ganiushin/MaGaRM/docs/cad.md

# CAD: сборка из скриптов и правки

## Как устроено

`cad/base/base_assembly.step` — исходная сборка. Скрипты меняют её по шагам:

| Скрипт | Что делает |
|---|---|
| `step1_J1.py` | J1 на DM-JH17-101: новое основание с кольцом под мотор и окнами под разъёмы |
| `step2_J2.py` | J2 на DM-JH17-101: мотор в барабане на конце плеча, вилка L2_base со щекой L2_cheek и подшипником 6705. J3 на DM-J4340P: плечо и вилка предплечья расширены симметрично, зазоры 1.75 мм |
| `step3_J4.py` | J4 на DM-J4340: корпус-барабан Ø63, ступица L4_right, вырез поперечины, выборка под ход мотора J6 (J5 ±90°) |
| `step4_gripper.py` | захват на DM-H3510: стакан L7_motor, рама на фланце Ø60, кривошип |
| `step5_logo.py` | логотип MaGaRM гравировкой 0.8 мм на плече (L3_back) |
| `make_viewer.py` | `viewer/model.json` для просмотрщика |
| `export_parts.py` | все печатные детали в `cad/parts/` (STEP + герметичные STL) и `parts.json` |
| `make_urdf.py` | `urdf/magarm.urdf` и сетки звеньев |

Полная пересборка занимает около 15 минут. Нужен [uv](https://docs.astral.sh/uv/), он сам поставит build123d:

```bash
cad/scripts/build_all.sh
```

Промежуточные сборки весят по 100–200 МБ, они складываются в `cad/build/` и в git не попадают.

## Правка

**В CAD.** Откройте деталь из `cad/parts/*.step` в Fusion 360, Onshape или FreeCAD и правьте прямым моделированием (Press Pull, Move face, Delete face). Чтобы видеть соседние детали, откройте полную сборку `cad/build/step5/magarm_step5_logo.step`.

**Параметрами.** Поменяйте число в начале скрипта и запустите `build_all.sh`:

| Файл | Параметр | Смысл |
|---|---|---|
| step1_J1.py | `R_OUT`, `R_IN`, `RING` | башня основания, расточка под корпус мотора, толщина кольца |
| step1_J1.py | `WIN_Y`, `WIN_Z` | окна под разъёмы J1 |
| step2_J2.py | `R_BORE`, `R_DRUM`, `WALL_F`, `WALL_B` | барабан плеча под мотор J2: расточка, наружный радиус, стенка под винты статора, задняя стенка |
| step2_J2.py | `W_FL`, `Z_FL`, `CH_T`, `R_CH` | вилка: полуширина и верх пола, толщина и радиус щеки с подшипником |
| step2_J2.py | `R_SPIGOT` | цапфа под подшипник 6705 на L3_back |
| step2_J2.py | `D_FORK`, `D_ARM` | раздвижка вилки J3 и половин плеча |
| step3_J4.py | `RI`, `RO` | внутренний и наружный радиус барабана J4 |
| step3_J4.py | `R_HUB` | ступица под выход мотора в L4_right |
| step3_J4.py | `PART_ANG`, `ROT_M` | угол разъёма L5_motor/L5_back, поворот мотора J4 |
| step4_gripper.py | `BOT`, `R_FL`, `R_FS`, `ROLL` | дно стакана, фланец, радиус винтов рамы, поворот мотора захвата (разъёмы) |

Ось J1 стоит под осью J2, в средней плоскости плеча. Высота выхода J1 (`Z_OUT` в step1_J1.py) и пол вилки (`Z_FL` в step2_J2.py) связаны: пол проходит в 1.6 мм под барабаном плеча. Меняются вместе, step2_J2.py это проверяет.

После каждого изменения скрипты проверяют, что тела валидны и объём изменился ровно на ожидаемую величину. Если булева операция не удалась, сборка падает с ошибкой, а не выдаёт битую деталь.
