ganiushin/MaGaRM/docs/electrical.md

# Электрика

## Питание

Все моторы питаются от одной шины 24 В:
- Damiao JH17 — 24–48 В, здесь работает на 24 В;
- Damiao 4340P и 4340 — номинал 24 В;
- H3510 — 24–30 В;
- EL05 работает от 15–60 В (номинал 48 В). На 24 В у него меньше максимальная скорость, около 200 об/мин, для запястья этого хватает.

Блок питания:
- **24 В, от 15 А.** В покое рука потребляет 1–2 А. Каждый JH17 на пиковом моменте берёт от шины до 7 А, номинально 1.6 А (паспорт, 24 В);
- **предохранитель 20 А** сразу после блока питания;
- **кнопка аварийного отключения**, которая разрывает +24 В. Это механическая кнопка, а не программная остановка: при пропадании питания моторы отпускают, и рука под своим весом падает, так что держите её в рабочей зоне без людей;
- **провод питания** от блока до основания — сечением от 1 мм² (18 AWG).

## CAN

Все 7 моторов сидят на одной шине CAN 2.0, 1 Мбит/с:
- Damiao используют стандартные 11-битные кадры;
- RobStride EL05 — расширенные 29-битные.

На одной шине они не мешают друг другу. Адреса:

| Сустав | Мотор | Протокол | ID |
|---|---|---|---|
| J1 | DM-JH17-101 | Damiao MIT | 0x01 (ответ 0x11) |
| J2 | DM-JH17-101 | Damiao MIT | 0x02 (ответ 0x12) |
| J3 | DM-J4340P | Damiao MIT | 0x03 (ответ 0x13) |
| J4 | DM-J4340 | Damiao MIT | 0x04 (ответ 0x14) |
| J5 | EL05 | RobStride | 5 |
| J6 | EL05 | RobStride | 6 |
| Захват | DM-H3510 | Damiao MIT | 0x07 (ответ 0x17) |

Топология:
- **шина — одна линия** без длинных ответвлений: основание → J1 → J2 → J3 → J4 → J5 → J6 → захват;
- **терминаторы 120 Ом на обоих концах:** один на адаптере USB–CAN (у CANable включается перемычкой), второй на захвате. Если в плате-переходнике H3510 терминатора нет, поставьте резистор 120 Ом между CAN_H и CAN_L в последнем разъёме;
- **проверка:** между CAN_H и CAN_L на выключенной шине должно быть около 60 Ом.

## Жгут

Моторы соединяются цепочкой кабелями XT30(2+2): два толстых провода питания и пара CAN в одном разъёме. У каждого мотора два таких разъёма, вход и выход.

| Участок | Где проходит кабель |
|---|---|
| Основание → J1 | через окно L1_base: два разъёма JH17 смотрят в два окна, спереди и сзади |
| J1 → J2 | снаружи, петлёй от второго окна основания к окну в L3_back у корня плеча: там единственный доступный разъём мотора J2 |
| J2 → J3 | ответвление от того же кабеля в окне L3_back, дальше по центральному каналу плеча (6×8 мм между половинами) |
| J3 → J4 | вдоль предплечья, в канал половин L4 |
| J4 → J5 | через цапфу барабана (отверстие Ø12) в плиту J5 |
| J5 → J6 → захват | по L6_link, затем вниз к окну стакана L7_motor |

H3510 подключается через плату-переходник Damiao (SH1.0 8 pin → XT30 + GH1.25), плата крепится снаружи стакана у окна. Длину кабелей подбирайте с запасом на полный ход суставов: J1 ±160°, J5 и J6 ±90°.

Мотор J2 стоит внутри плеча и вращается вместе с ним. Его разъёмы смотрят вдоль плеча: один в окно L3_back у корня балки, второй назад, и он закрыт стенкой барабана. Открыть второй нельзя: вилка проходит в 1.6 мм от барабана, и торчащий штекер упёрся бы в её пол. Поэтому на J2 приходит один кабель с ответвлением: либо Y-разветвитель XT30(2+2), либо два провода в один штекер. Оба разъёма мотора соединены внутри, так что на шине CAN и на питании это ничего не меняет. Петля J1 → J2 должна выбирать и ход J1, и ход J2 (0…200°).

## Адаптер USB–CAN

Подойдёт любой адаптер с прошивкой candleLight/gs_usb, например CANable 2.0. В Linux он виден как `can0` без драйверов:

```bash
sudo ip link set can0 type can bitrate 1000000
sudo ip link set can0 up
candump can0          # из can-utils: здесь видны кадры моторов
```

Адаптер Damiao USB2CAN работает через последовательный порт, это не SocketCAN, и с этим софтом без доработки он не заработает.
