ganiushin/MaGaRM/docs/motors_check.md

# Проверка живых моторов перед печатью

Корпуса построены по официальным STEP-моделям Damiao, а у EL05 — по модели из исходной сборки. Прежде чем печатать, сверьте с моторами в руках следующее. Там, где что-то не совпадёт, поправьте параметр в скрипте и пересоберите (см. [cad.md](cad.md)).

## DM-JH17-101 (J1, J2)

| Что | Ожидается | Где влияет |
|---|---|---|
| Корпус | Ø80 × 40 | расточка Ø82 в L1_base (`R_IN`), расточка Ø80.8 в барабане плеча (`R_BORE`) |
| Выходной фланец | Ø62, выступает на 11 мм над передним торцом корпуса | отверстие Ø64 в кольце основания и в стенке барабана (`R_OPEN`); гнездо Ø62.8 × 4 в щеке L2_base |
| Задняя крышка | Ø70 × 19, полная длина мотора 70 | высота основания, длина барабана плеча (68.75 мм снаружи) |
| Передние отверстия | 8×M3 на Ø74, глубина резьбы 10.5 | кольцо L1_base (Ц M3×12), стенка барабана L3_motor (С M3×12) |
| Выход | 8 отверстий на Ø54 парами через 30°: 10 мм Ø3.2, за ними резьба M3 на 7.5 мм; 4 штифта Ø3 на Ø54, выступают на 2 мм | пол и щека L2_base, винты Ц M3×25 |
| Задние отверстия | 4×M4 на Ø61, глубина 4.5 | не используются |
| Разъёмы XT30(2+2) | два, радиально на задней крышке, друг напротив друга, в 54 мм от переднего торца корпуса | окна в L1_base, окно в L3_back у корня плеча |
| Полый вал | Ø15 насквозь | не используется |

Перед сборкой прокрутите выход каждого JH17 рукой без питания: ход должен быть ровным, без ступенек и без люфта на реверсе.

## DM-J4340P (J3) и DM-J4340 (J4)

| Что | Ожидается | Где влияет |
|---|---|---|
| Диаметр корпуса | Ø57.0 | гнёзда в L3_motor и L3_back, барабан J4 (`RI` в step3_J4.py) |
| Выходной фланец | Ø38 (4340P), выступает на 1.75 мм над передним торцом | расточка Ø39.5×2.5 в L3_motor |
| Длина от выхода до заднего торца | 56.5 (4340P), 53.25 (4340) | ширина плеча, барабан J4 |
| Передние отверстия | 6×M3 на Ø50, глубина резьбы 5.4 | винты С M3×8 |
| Задние отверстия | 4×M3 на Ø38, глубина 3.9 | винты С M3×6 |
| Выход | 6×M3 на Ø27, штифты Ø4 на Ø24, глубина штифта 4–5 | L4_right |
| Разъёмы XT30(2+2) у 4340P | радиально, сверху и снизу у заднего торца | кольцевой зазор в плече |
| Выход кабеля у 4340 (J4) | с заднего торца | цапфа барабана, отверстие Ø12 |

Выходной фланец вращается, поэтому угол поворота его отверстий при сборке значения не имеет: фланец доворачивают рукой.

## DM-H3510 (захват)

| Что | Ожидается | Где влияет |
|---|---|---|
| Корпус | Ø42 × 29 мм плюс выходной диск Ø36 × 3 мм | стакан L7_motor (`R_BORE`) |
| Задний буртик | Ø20 × 1.5 | отверстие Ø21 в дне стакана |
| Задние отверстия | 4×M3 на Ø36, глубина 6.6 | винты С M3×8 |
| Выход | 6×M3 на Ø16, глубина 3.5, центральный буртик Ø7 × 0.8 | кривошип |
| Разъёмы | SH1.0 8 pin (питание + CAN) и 3 pin (отладка), сбоку у заднего торца | окно в стакане под углом 300° (`ROLL`) |

## RobStride EL05 (J5, J6)

Посадочные места под эти моторы не менялись. Сверьте только, что у вашей партии тот же рисунок крепления, что на фото в карточке товара.

## Подготовка моторов перед сборкой

1. **Damiao.** В программе Damiao Debugging Tools задайте каждому мотору CAN_ID и MASTER_ID по таблице, режим MIT и сохраните:

   | Сустав | CAN_ID | MASTER_ID |
   |---|---|---|
   | J1 | 0x01 | 0x11 |
   | J2 | 0x02 | 0x12 |
   | J3 | 0x03 | 0x13 |
   | J4 | 0x04 | 0x14 |
   | Захват | 0x07 | 0x17 |

   Там же посмотрите PMAX, VMAX и TMAX. Софт сам читает эти значения из мотора, но они должны быть ненулевыми. У JH17 поставьте PMAX 12.5, VMAX 5, TMAX 60: заводские значения в документации не указаны, а TMAX должен покрывать пиковые 54 Н·м.
2. **RobStride EL05.** В утилите RobStride задайте CAN ID 5 (J5) и 6 (J6).
3. **Скорость шины.** У всех моторов CAN 1 Мбит/с, это заводская настройка.
