ganiushin/MaGaRM/docs/bom.md

# Что печатать и что купить

## 1. Печать

Все файлы лежат в `cad/parts/`: STL для слайсера и STEP для CAD. Каждая STL проверена на герметичность. Детали выгружены в положении сборки, поэтому в слайсере их нужно положить на ровную грань.

Размеры:
- самые длинные детали — половины плеча, 272 мм;
- нужен стол от 256×256 мм, на нём плечо печатается по диагонали.

Материал:
- **PETG или PLA+.** Детали, которые касаются моторов (L1_base, L2_base, L3_*, L4_*, L5_*, L7_motor), лучше печатать из PETG: моторы греются до 50–60 °C.
- **Подушки пальцев** (`jaw_pad*`) — из TPU 95A.

Режим печати: слой 0.2 мм, 4 периметра, заполнение 30–40 % гироид.

Логотип на L3_back — гравировка 0.8 мм. Чтобы буквы были другого цвета, поставьте в слайсере смену филамента на высоте гравировки или закрасьте её после печати.

| Файл | Что это | Объём, см³ | Габарит, мм |
|---|---|---|---|
| L1_base | основание, в нём мотор J1 | 134.9 | 95 × 95 × 80 |
| L2_base | вилка плеча: пол на выходе J1 и щека под фланец мотора J2 | 136.6 | 70 × 84 × 96 |
| L2_cheek | вторая щека вилки с гнездом подшипника 6705 | 38.2 | 70 × 10 × 85 |
| L3_motor | плечо, сторона моторов; у J2 барабан под мотор | 149.1 | 272 × 89 × 36 |
| L3_back | плечо, задняя половина, логотип MaGaRM, цапфа подшипника J2 | 165.7 | 272 × 89 × 41 |
| L4_right | предплечье, сторона мотора J4 | 150.4 | 240 × 124 × 44 |
| L4_left | предплечье, сторона подшипника | 143.9 | 240 × 124 × 42 |
| L5_motor | барабан запястья, плита J5 | 32.2 | 98 × 70 × 60 |
| L5_back | барабан запястья, крыша | 23.1 | 72 × 63 × 55 |
| L5_shake | кожух мотора J5 | 18.8 | 60 × 50 × 48 |
| L6_link | звено J5–J6 | 19.6 | 56 × 35 × 32 |
| L7_base | фланец выхода J6 | 10.6 | 46 × 46 × 14 |
| L7_cover | задняя крышка захвата | 9.5 | 46 × 46 × 14 |
| L7_motor | стакан мотора захвата | 14.9 | 60 × 60 × 33 |
| gripper_frame | рама губок с рельсом | 29.4 | 191 × 60 × 25 |
| gripper_crank | кривошип захвата | 10.5 | 65 × 49 × 10 |
| gripper_link_1, gripper_link_2 | тяги кривошип–губка | 2 × 2.5 | 55 × 17 × 5 |
| jaw_1, jaw_1_m | губки (левая/правая) | 2 × 19.9 | 56 × 42 × 31 |
| jaw_pad, jaw_pad_m | подушки пальцев, TPU | 2 × 5.4 | 48 × 36 × 12 |
| camera_bracket | кронштейн камеры | 45.7 | 98 × 80 × 58 |
| camera_clamp | хомут камеры | 10.2 | 80 × 30 × 15 |

Всего 24 детали и около 1.20 л сплошного объёма. При 4 периметрах и 35 % заполнения это примерно 0.9 кг пластика, так что берите катушку 1 кг PETG и ещё немного TPU.

## 2. Покупки

### Моторы

| Сустав | Мотор | Кол-во | Масса |
|---|---|---|---|
| J1, J2 | Damiao DM-JH17-101-2EC (волновой редуктор 101:1), 24 В | 2 | 985 г |
| J3 | Damiao DM-J4340P-2EC, 24 В | 1 | 362 г |
| J4 | Damiao DM-J4340-2EC, 24 В | 1 | 362 г |
| J5, J6 | RobStride EL05 (EduLite 05) | 2 | 242 г |
| Захват | Damiao DM-H3510, 24 В, с платой-переходником на XT30 | 1 | 116 г |

### Подшипники, рельс, штифты

| Позиция | Размер | Кол-во |
|---|---|---|
| Подшипник 6705-2RS (J2, J3) | 25×32×4 | 2 |
| Подшипник 6704-2RS | 20×27×4 | 1 |
| Рельс MGN7 | длина 170 мм | 1 |
| Каретка MGN7C | — | 2 |
| Штифт Ø4×12 (выход J3) | DIN 6325 | 3 |
| Штифт Ø4×10 (выход J4) | DIN 6325 | 3 |
| Штифт Ø3×6 | — | 2 |
| Штифт Ø3×10 (рама захвата) | — | 2 |
| Штифт Ø2×14 (губки) | — | 4 |

### Термовставки (вплавляются паяльником)

| Размер | Где |
|---|---|
| M2 × 3.5 | губки |
| M3 × 4, Ø4.5, под отверстие Ø4.0 | рама захвата (6 шт.), дно стакана L7_motor (4 шт.) |
| M3 × 5 | плечо, предплечье, L5, L7 (как в исходных деталях) |
| M4 × 8, Ø5.6 | торец пола L2_base под щеку L2_cheek (3 шт.) |
| M4 × 5 | L6_link |

### Винты

**С = винт с потайной головкой (DIN 7991), Ц = винт с цилиндрической головкой (DIN 912).**

Длины у моторов Damiao посчитаны по CAD так, чтобы винт не упирался в дно резьбы мотора. Глубина резьбы:
- JH17: спереди 10.5 мм; на выходе сначала 10 мм гладкого отверстия Ø3.2, за ним 7.5 мм резьбы; сзади M4 на 4.5 мм;
- 4340P: спереди 5.4 мм, сзади 3.9 мм, на выходе 7.5 мм;
- H3510: сзади 6.6 мм, на выходе 3.5 мм.

| Узел | Винт | Кол-во |
|---|---|---|
| J1: мотор к кольцу основания | Ц M3×12 | 8 |
| J1: выход к полу вилки L2_base | Ц M3×25 | 8 |
| J2: мотор к стенке барабана L3_motor (снаружи) | С M3×12 | 8 |
| J2: выход к щеке L2_base (снаружи вилки) | Ц M3×25 | 8 |
| Щека L2_cheek к полу вилки (во вставки) | Ц M4×16 + шайба M4 | 3 |
| J3: мотор к L3_motor (передние) | С M3×8 | 6 |
| J3: задняя крышка мотора (L3_back) | С M3×6 | 4 |
| J3: выход к L4_right | С M3×18 | 6 |
| J4: выход к L4_right | Ц M3×10 | 6 |
| J4: мотор к задней стенке барабана | С M3×6 | 4 |
| L5_back к L5_motor (ушки у плиты) | С M3×8 | 2 |
| J5: мотор к плите L5_motor | С M3×10 | 8 |
| L5_shake | С M3×14 | 4 |
| L6_link | Ц M4×14 | 5 |
| J6: мотор к L6_link | Ц M4×10 | 6 |
| J6: мотор к L7_base | С M3×10 | 4 |
| L7_base к L7_cover | Ц M3×10 | 4 |
| L7_cover к стакану (во вставки) | С M3×6 | 4 |
| H3510 к дну стакана | С M3×8 | 4 |
| Рама к фланцу стакана (во вставки) | С M3×6 | 6 |
| Кривошип к выходу H3510 | Ц M3×10 | 6 |
| Рельс, каретки, губки | Ц M2×10 — 8, Ц M2×8 — 8, С M2×8 — 8 | 24 |
| Шарниры тяг | плечевой винт M4×12 — 2, M4×16 — 2, шайба M4×7×1 — 2, гайка M4 самоконтр. — 2 | 8 |
| Половины плеча (поперёк, плечо шире на 3.75 мм) | С M3×35 | 6 |
| Половины предплечья (поперёк, предплечье шире на 5.25 мм) | С M3×50 — 3, С M3×45 — 2, С M3×35 — 2 | 7 |

Порядок сборки плеча задаётся доступом к винтам:
1. мотор J1 вставляется в основание снизу и притягивается через кольцо;
2. L2_base ставится на выход J1, штифты мотора входят в гнёзда, восемь винтов закручиваются сверху в пол вилки, пока в ней нет плеча;
3. мотор J2 вставляется в барабан L3_motor изнутри, разъёмами вдоль плеча, и притягивается восемью потайными винтами снаружи;
4. L3_back закрывает плечо, на его цапфу надевается подшипник 6705;
5. плечо заводится в вилку сбоку: фланец мотора входит в гнездо щеки L2_base, штифты — в свои гнёзда, восемь винтов закручиваются снаружи щеки;
6. L2_cheek надевается на подшипник и притягивается к торцу пола последней. Её отверстия Ø5.5 под винты M4 дают щеке сесть там, где стоит подшипник: ось J2 уже задана мотором, и перекошенная вторая опора гнула бы выход волнового редуктора. Сначала наживите винты, проверните плечо рукой на весь ход и только потом затяните.

Штифты Ø3 на выходах JH17 стоят в моторе с завода. Заднюю крышку мотора J2 ничто не держит и не нагружает: резьбу M4 в ней Damiao нагружать не разрешает. Цапфа под 6705 сделана Ø25.1 под отверстие Ø25; если подшипник не надевается, цапфу подшлифуйте.

Поперечные винты половин плеча и предплечья удлинены на ширину расширения. Перед покупкой сверьте их с глубиной отверстий в STEP: если винт упирается, возьмите на 5 мм короче.

### Электрика (подробнее в [electrical.md](electrical.md))

| Позиция | Кол-во |
|---|---|
| Блок питания 24 В, от 15 А (360 Вт) | 1 |
| Кнопка аварийного отключения на линии 24 В + предохранитель 20 А | 1 |
| Адаптер USB–CAN, совместимый с gs_usb/candleLight (CANable 2.0 и аналоги) | 1 |
| Кабели-шлейфы XT30(2+2) с силиконовым проводом, плоские | 7 |
| Терминатор 120 Ом (на последнем моторе, если в нём не включён) | 1 |

### Камера

Кронштейн рассчитан на модуль камеры примерно 42×45 мм с платой-переходником, как в исходной модели. Под VLA подойдёт любая USB-камера с объективом 90–120° такого размера. Если корпус другой, кронштейн придётся подогнать.
