ganiushin/MaGaRM/cad/motors/DM-JH17-2EC.stp

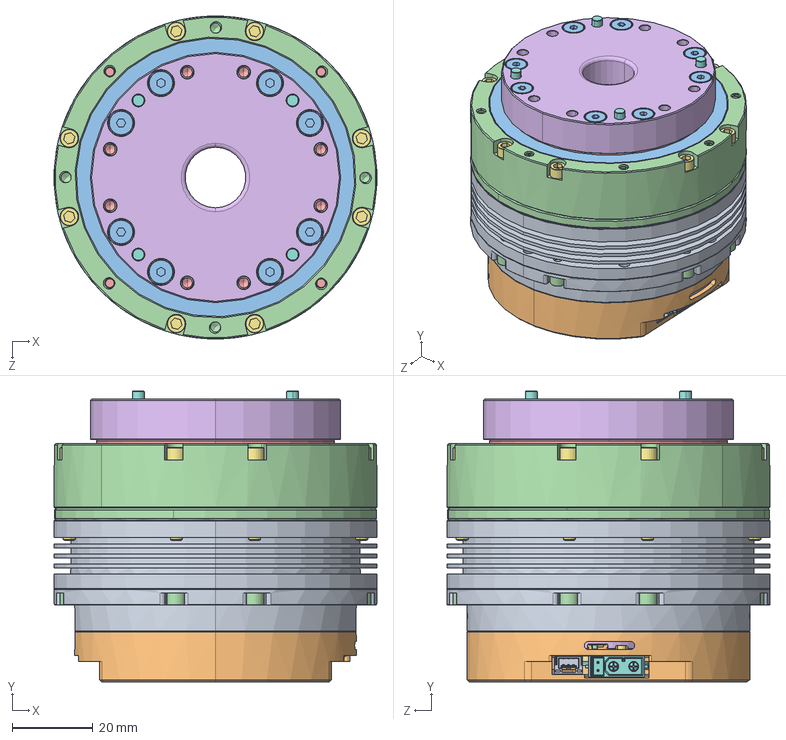
[picture p1: CAD file, 2026-10-12]
cad/motors/DM-JH17-2EC.stp
80.0 x 72.0 x 80.0 mm
JH17-001-003
HS-17-xxx-III-DM-17
JH17-004-005
深沟球轴承6703-17×23×4
H14&17驱动板
JH17-006
内六角薄头螺钉M3×12 x 8
内六角非标小头螺钉M3×4-头径4.5 x 8
内六角超薄头螺钉M2×5 x 4
内六角沉头螺钉M3×14 x 4
内六角非标小头螺钉M3×20-头径4.5 x 8
销钉3×12-GB119.1 x 4
