ganiushin/MaGaRM/cad/parts/L1_base.step

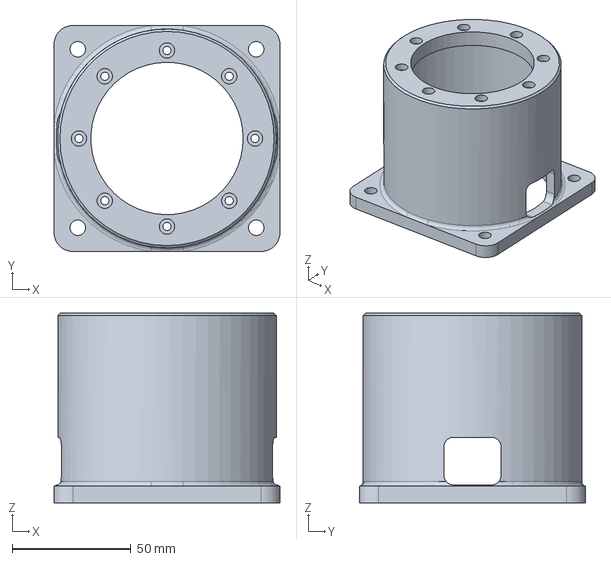
[picture p2: CAD file, 2026-10-12]
cad/parts/L1_base.step
95.0 x 95.0 x 79.8 mm
