ganiushin/MaGaRM/sim/assets/link6_static.stl

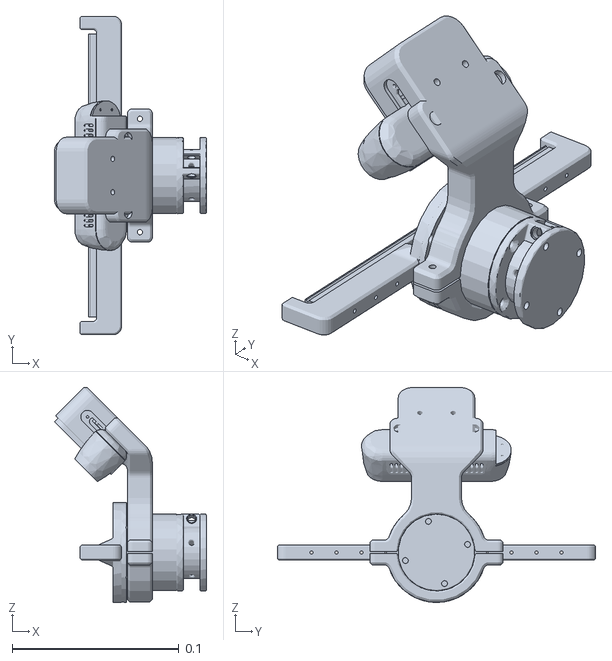
[picture p3: CAD file, 2026-10-12]
sim/assets/link6_static.stl
0.0913 x 0.191 x 0.129
