ganiushin/MaGaRM/urdf/meshes/link2.stl

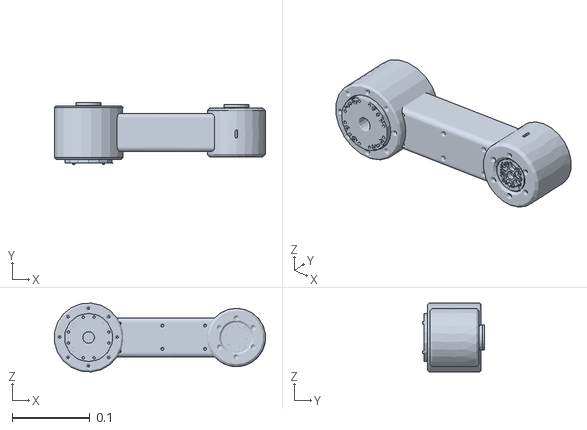
[picture p4: CAD file, 2026-10-12]
urdf/meshes/link2.stl
0.271 x 0.0802 x 0.0886
