ganiushin/MaGaRM/cad/motors/DM-H3510.stp

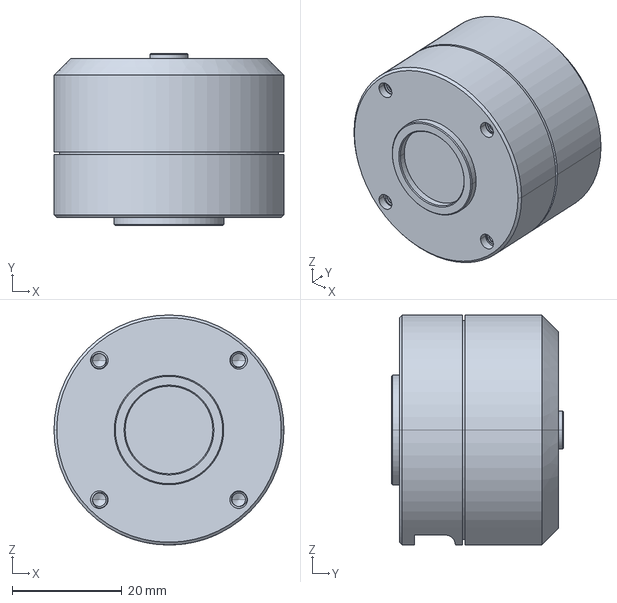
[picture p5: CAD file, 2026-10-07]
cad/motors/DM-H3510.stp
42.0 x 31.5 x 42.0 mm
