ganiushin/MaGaRM/cad/parts/gripper_link_2.step

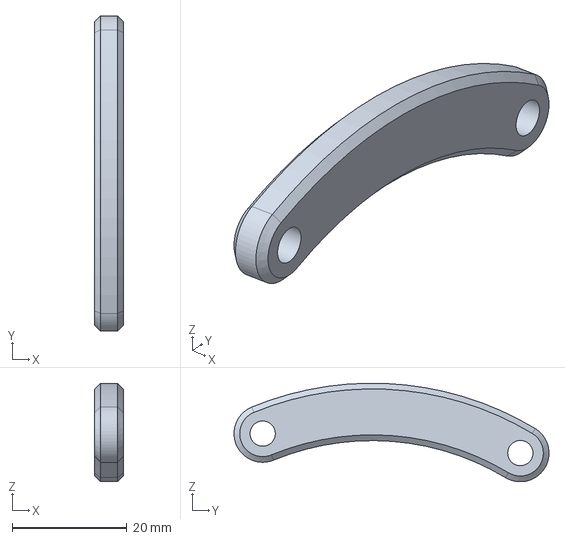
[picture p6: CAD file, 2026-10-12]
cad/parts/gripper_link_2.step
5.00 x 54.9 x 17.2 mm
