ganiushin/MaGaRM/sim/assets/pad_r.stl

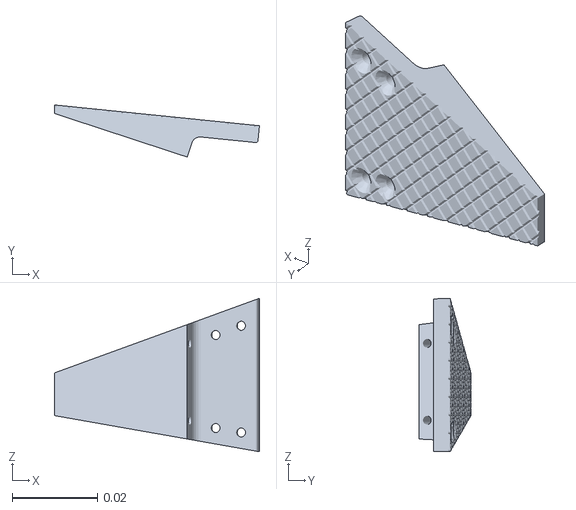
[picture p7: CAD file, 2026-10-12]
sim/assets/pad_r.stl
0.048 x 0.0122 x 0.0359
