ganiushin/MaGaRM/urdf/meshes/base_link.stl

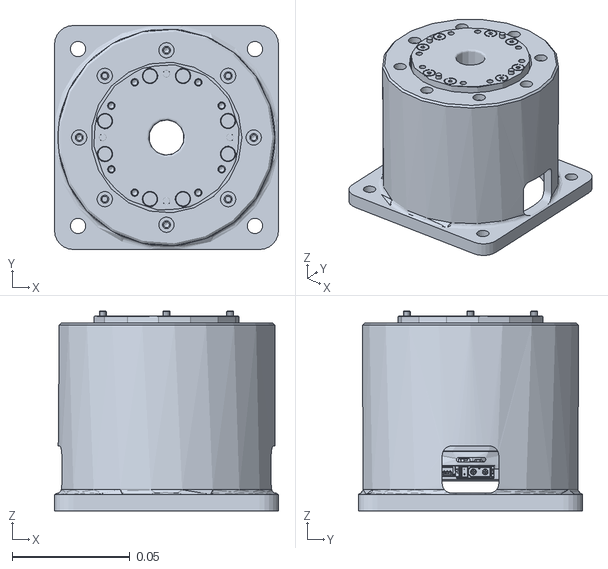
[picture p8: CAD file, 2026-10-12]
urdf/meshes/base_link.stl
0.095 x 0.095 x 0.0847
