ganiushin/MaGaRM/urdf/meshes/link6.stl

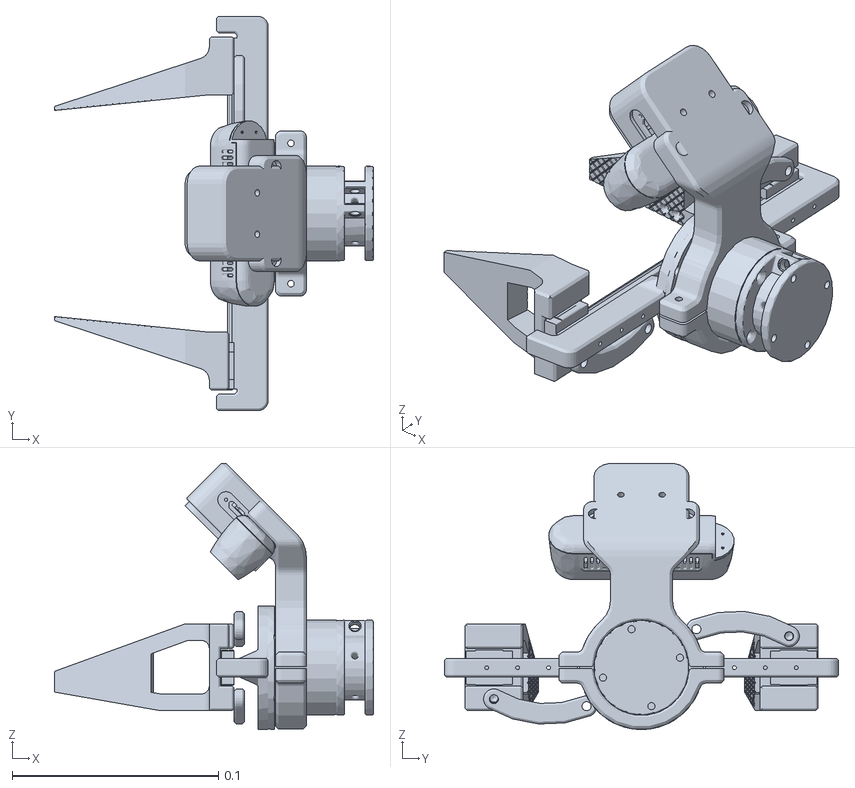
[picture p9: CAD file, 2026-10-12]
urdf/meshes/link6.stl
0.155 x 0.191 x 0.129
