ganiushin/MaGaRM/cad/parts/L3_back.step

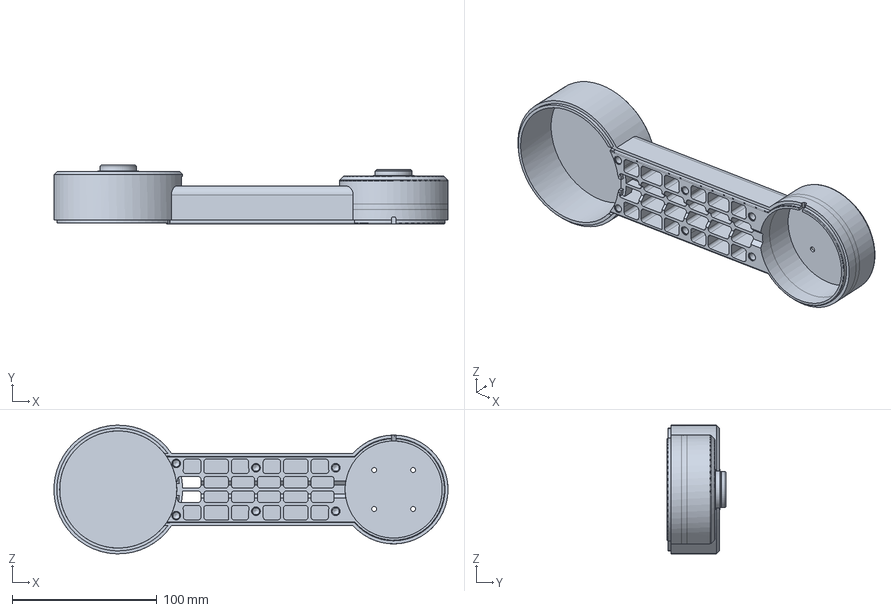
[picture p10: CAD file, 2026-10-12]
cad/parts/L3_back.step
271.8 x 40.6 x 88.8 mm
