ganiushin/MaGaRM/sim/assets/handle_l.stl

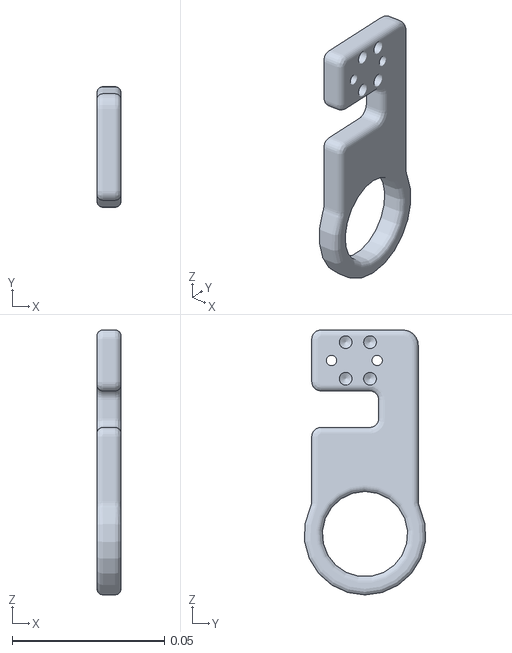
[picture p11: CAD file, 2026-10-12]
sim/assets/handle_l.stl
0.008 x 0.0397 x 0.087
