ganiushin/MaGaRM/urdf/meshes/link5.stl

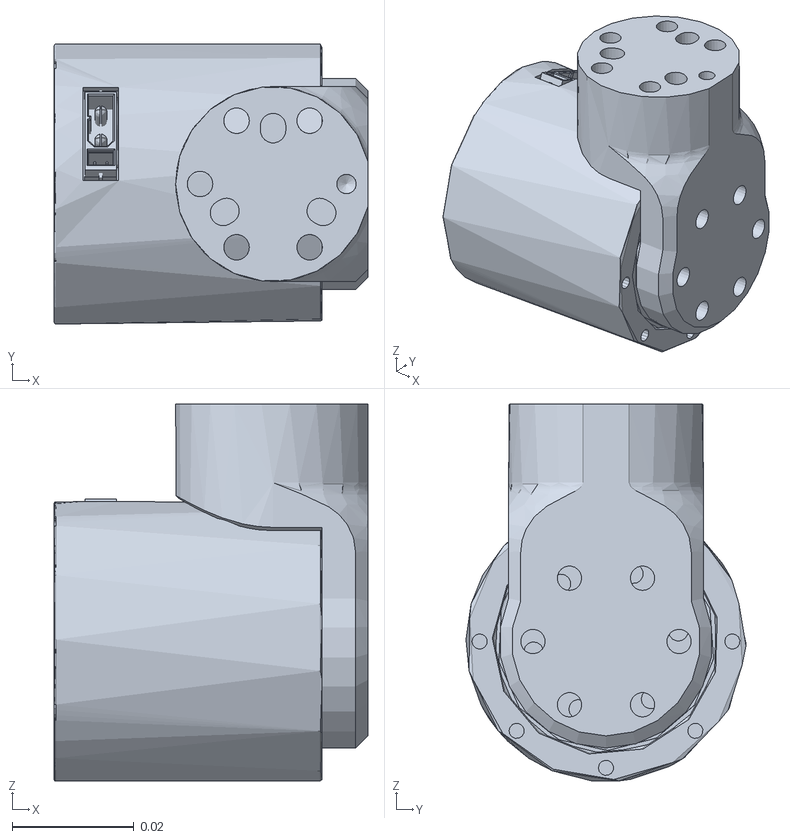
[picture p12: CAD file, 2026-10-12]
urdf/meshes/link5.stl
0.0515 x 0.046 x 0.0619
