ganiushin/MaGaRM/cad/parts/L7_cover.step

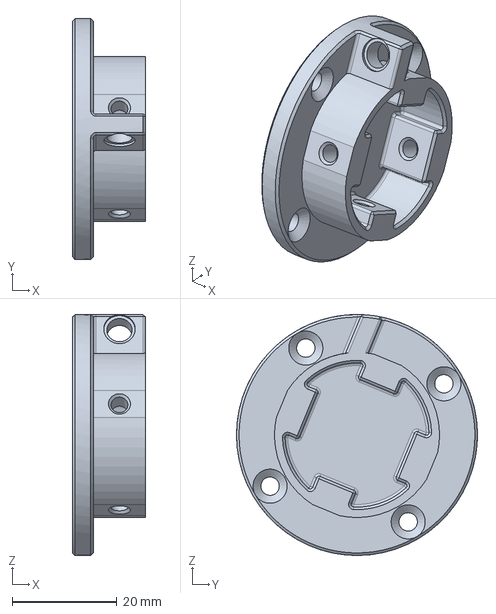
[picture p13: CAD file, 2026-10-12]
cad/parts/L7_cover.step
14.0 x 46.0 x 46.0 mm
