ganiushin/MaGaRM/sim/assets/jaw_l.stl

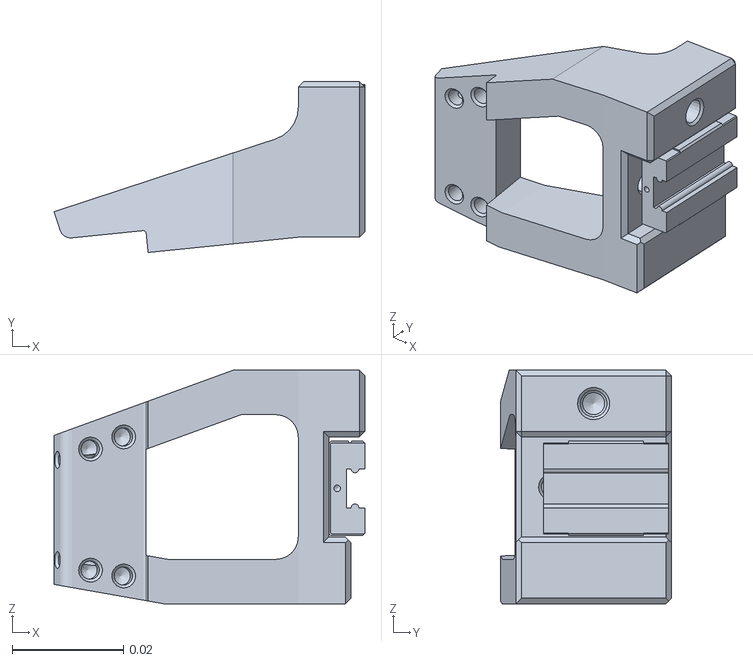
[picture p14: CAD file, 2026-10-12]
sim/assets/jaw_l.stl
0.0559 x 0.0307 x 0.042
