ganiushin/MaGaRM/urdf/meshes/link1.stl

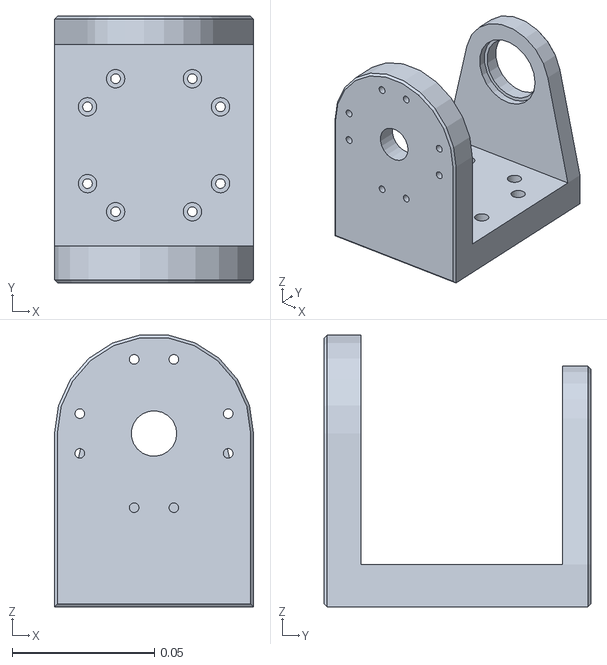
[picture p15: CAD file, 2026-10-12]
urdf/meshes/link1.stl
0.07 x 0.0938 x 0.0956
