ganiushin/MaGaRM/cad/parts/L2_base.step

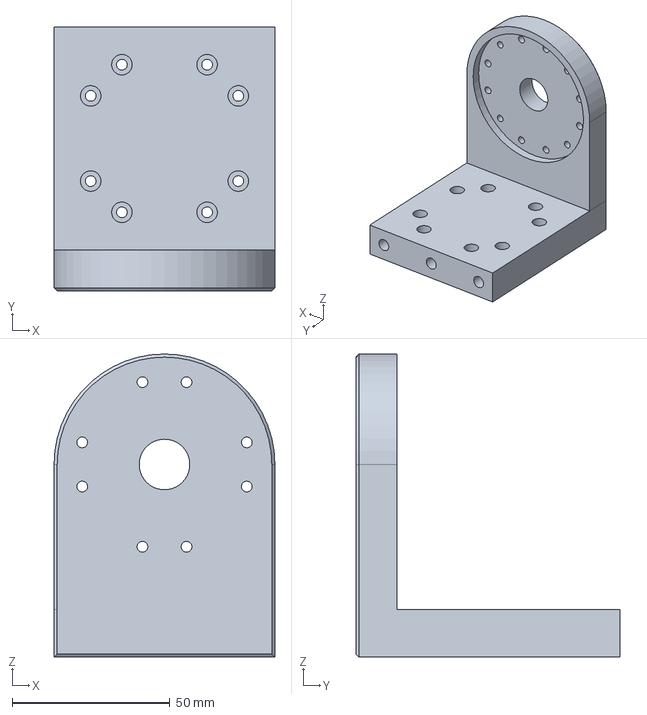
[picture p16: CAD file, 2026-10-12]
cad/parts/L2_base.step
70.0 x 83.8 x 96.0 mm
