ganiushin/MaGaRM/urdf/meshes/link4.stl

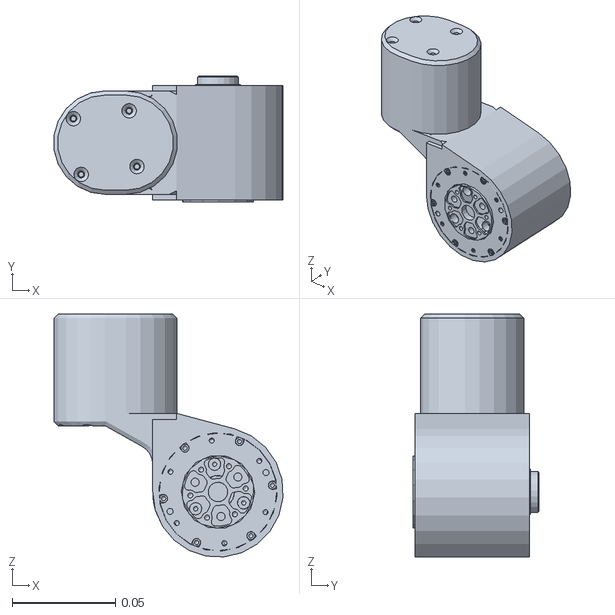
[picture p17: CAD file, 2026-10-12]
urdf/meshes/link4.stl
0.111 x 0.0608 x 0.117
