ganiushin/MaGaRM/cad/parts/L3_motor.step

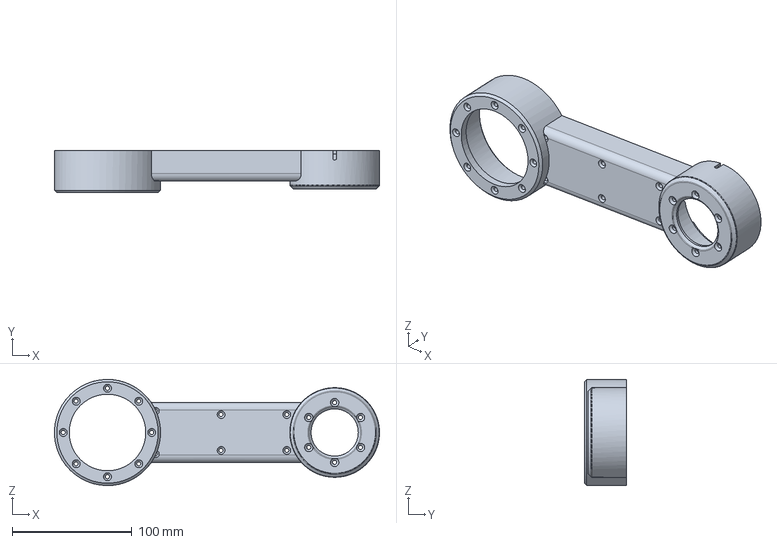
[picture p18: CAD file, 2026-10-12]
cad/parts/L3_motor.step
271.8 x 35.5 x 88.8 mm
