ganiushin/MaGaRM/sim/assets/rod_r.stl

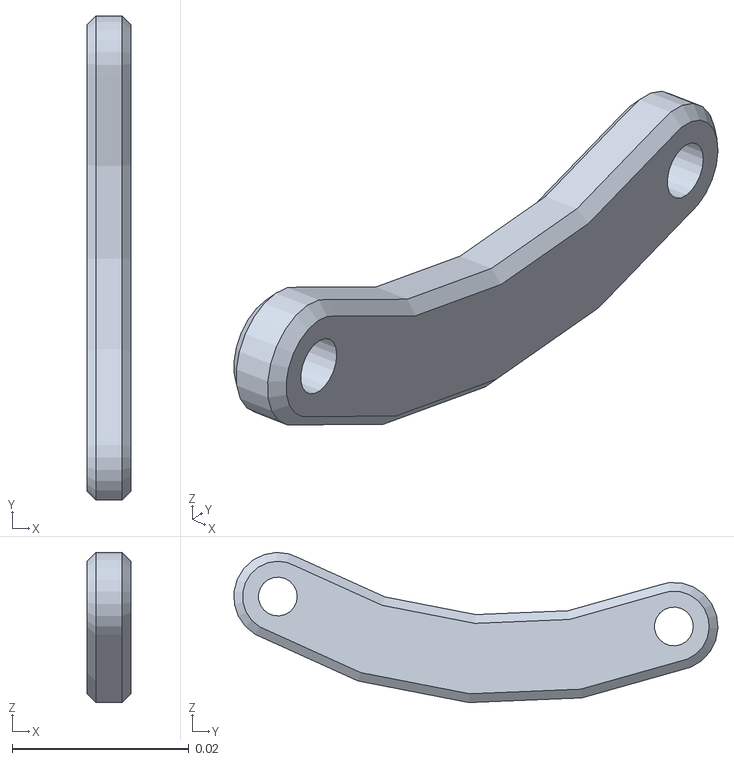
[picture p19: CAD file, 2026-10-12]
sim/assets/rod_r.stl
0.005 x 0.0548 x 0.017
