ganiushin/MaGaRM/urdf/meshes/gripper_link.stl

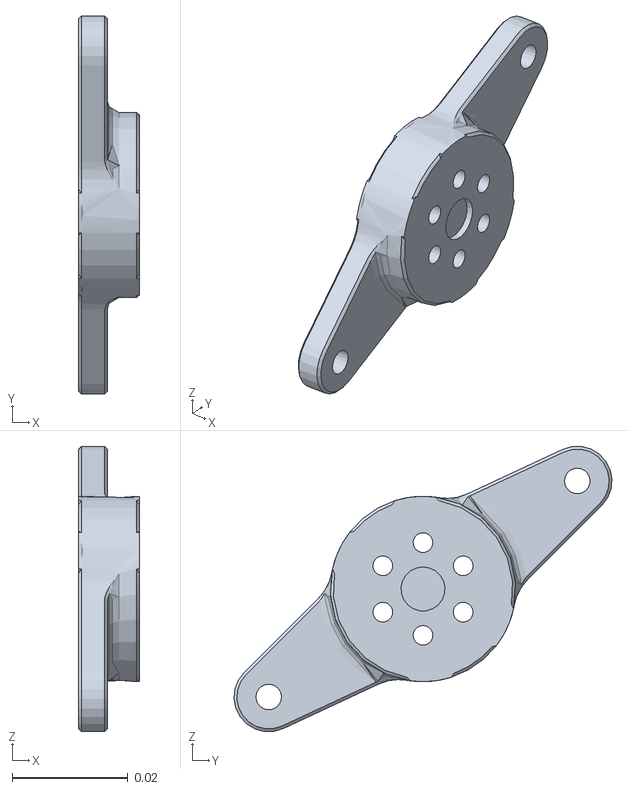
[picture p20: CAD file, 2026-10-07]
urdf/meshes/gripper_link.stl
0.0105 x 0.0652 x 0.0492
