ganiushin/MaGaRM/cad/parts/L5_back.step

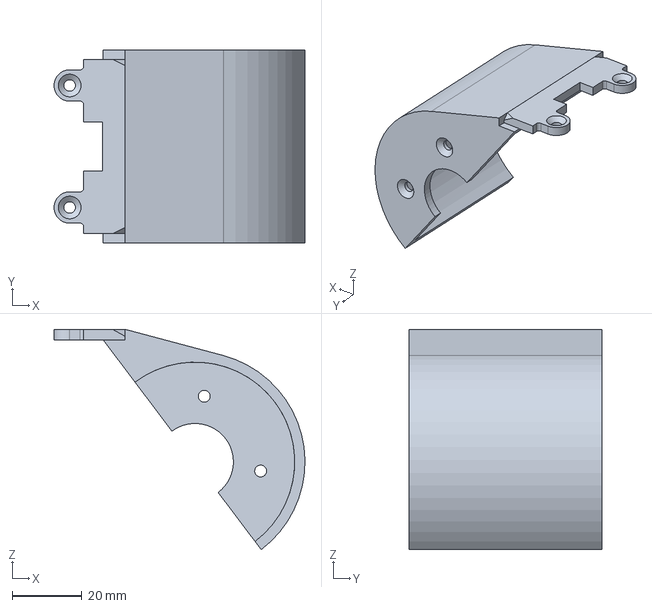
[picture p21: CAD file, 2026-10-12]
cad/parts/L5_back.step
72.0 x 55.2 x 63.2 mm
