ganiushin/MaGaRM/urdf/meshes/link3.stl

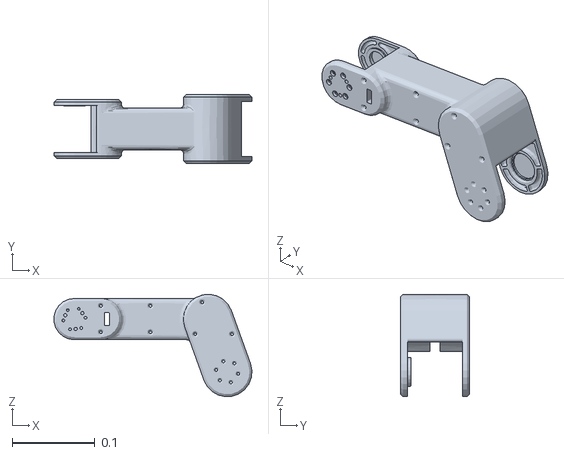
[picture p22: CAD file, 2026-10-07]
urdf/meshes/link3.stl
0.24 x 0.0833 x 0.124
