ganiushin/MaGaRM/cad/parts/camera_bracket.step

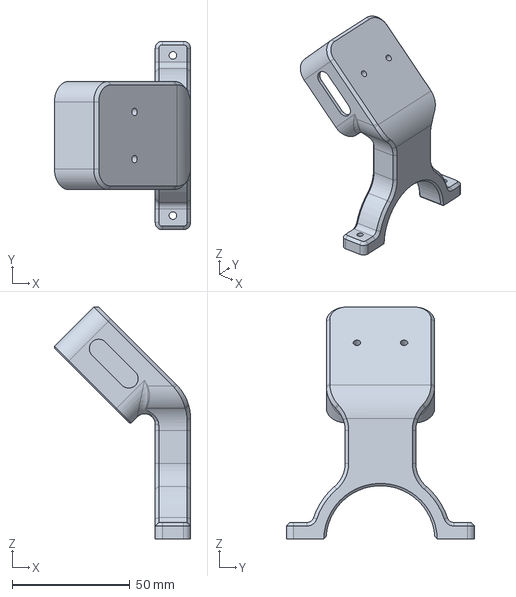
[picture p23: CAD file, 2026-10-12]
cad/parts/camera_bracket.step
57.8 x 80.0 x 98.5 mm
