ganiushin/MaGaRM/cad/parts/gripper_frame.step

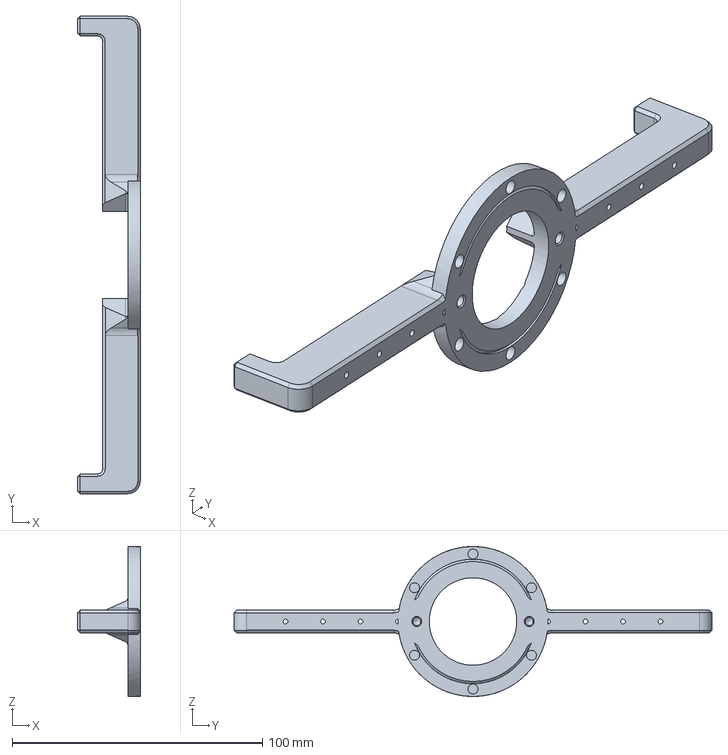
[picture p24: CAD file, 2026-10-12]
cad/parts/gripper_frame.step
25.0 x 191.0 x 60.0 mm
