ganiushin/MaGaRM/cad/parts/L4_left.step

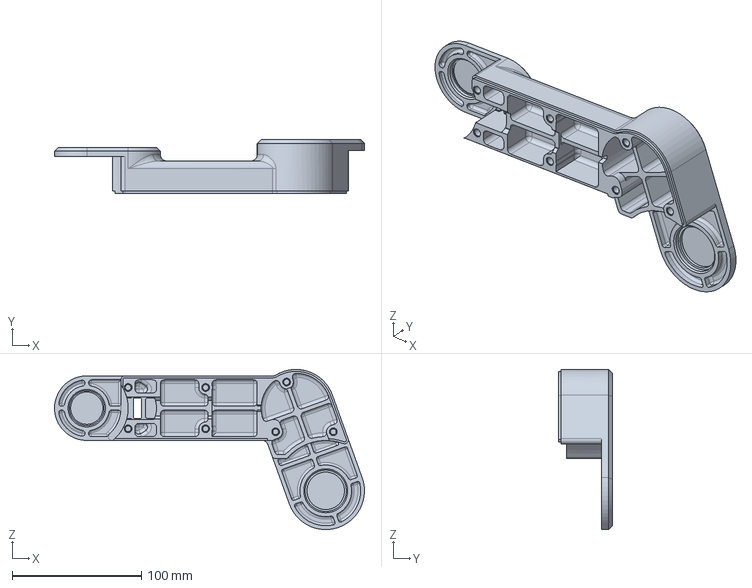
[picture p25: CAD file, 2026-10-12]
cad/parts/L4_left.step
240.0 x 41.6 x 124.0 mm
