ganiushin/MaGaRM/cad/parts/L5_motor.step

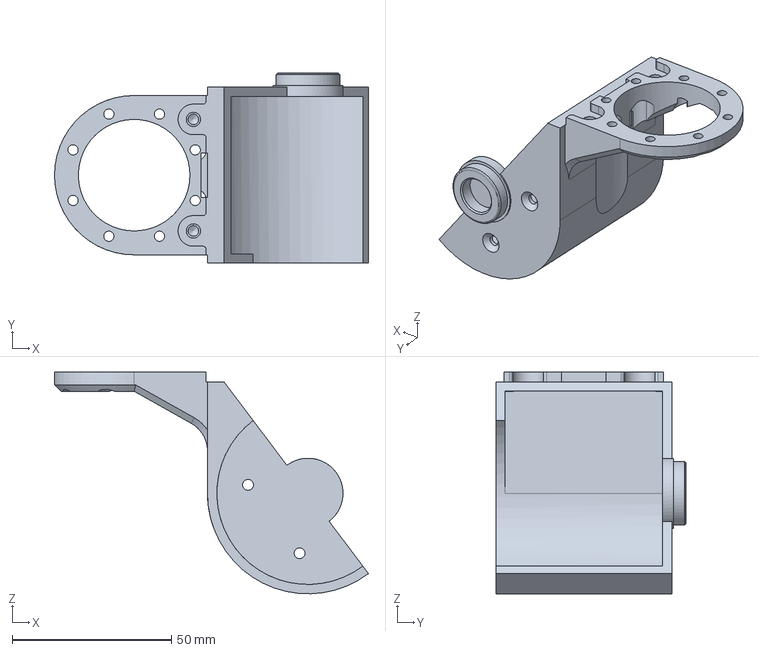
[picture p26: CAD file, 2026-10-12]
cad/parts/L5_motor.step
98.5 x 59.8 x 69.5 mm
