ganiushin/MaGaRM/cad/parts/L4_right.step

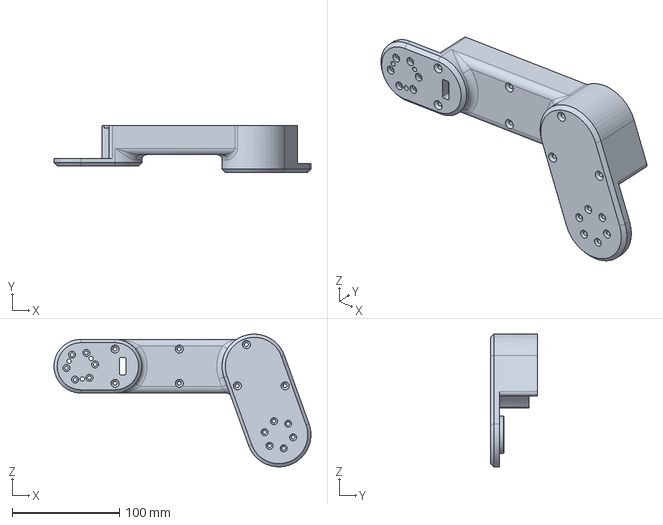
[picture p27: CAD file, 2026-10-12]
cad/parts/L4_right.step
240.0 x 43.6 x 124.0 mm
