ganiushin/MaGaRM/cad/parts/L6_link.step

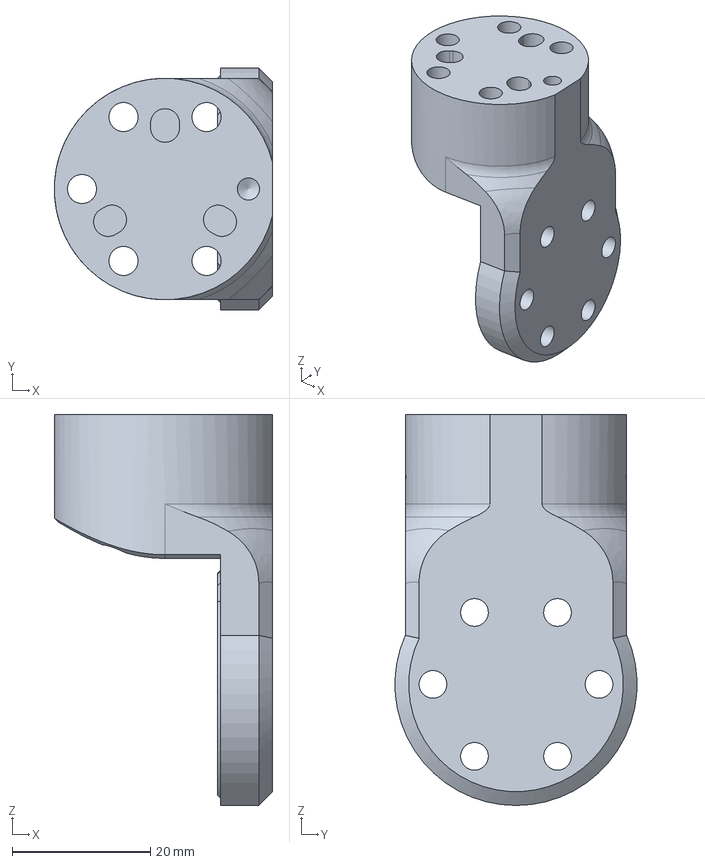
[picture p28: CAD file, 2026-10-12]
cad/parts/L6_link.step
31.5 x 35.0 x 56.5 mm
