ganiushin/MaGaRM/cad/parts/L7_base.step

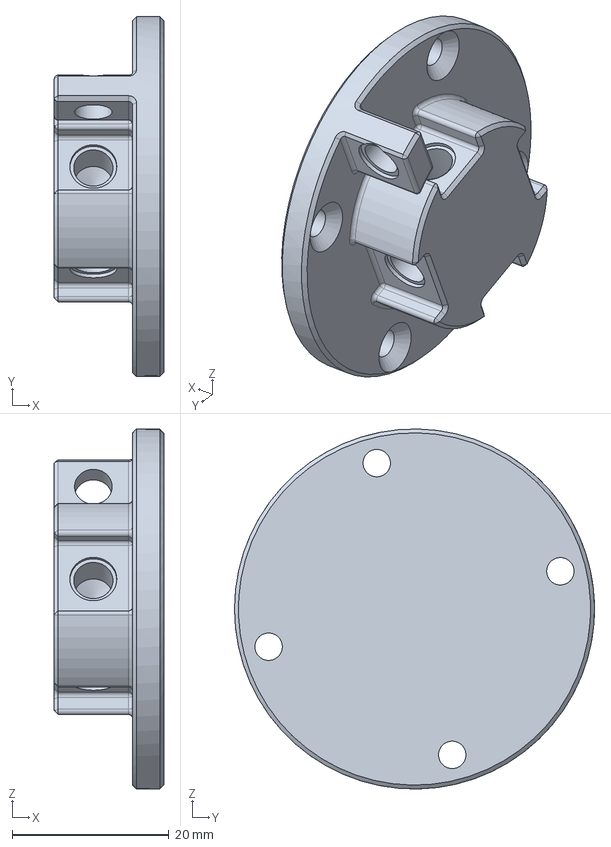
[picture p29: CAD file, 2026-10-12]
cad/parts/L7_base.step
14.0 x 46.0 x 46.0 mm
