ganiushin/MaGaRM/cad/parts/jaw_pad_m.step

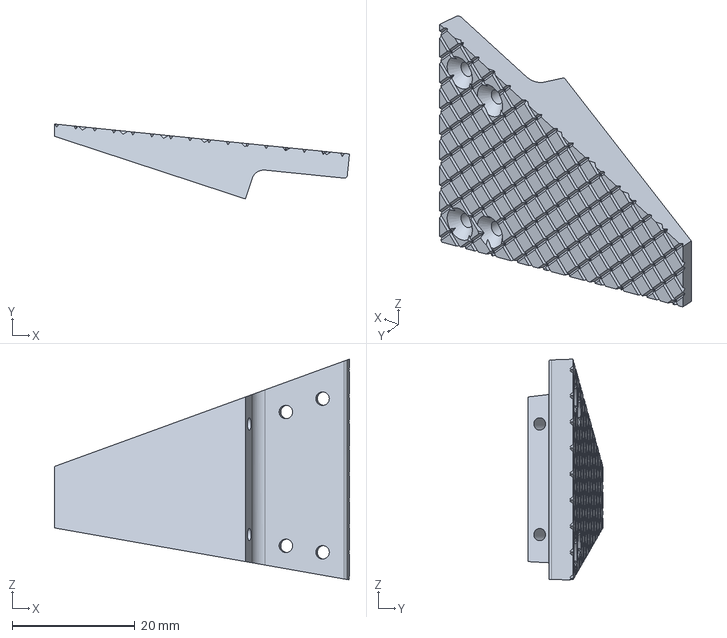
[picture p30: CAD file, 2026-10-12]
cad/parts/jaw_pad_m.step
48.0 x 12.2 x 35.9 mm
