ganiushin/MaGaRM/cad/parts/gripper_crank.step

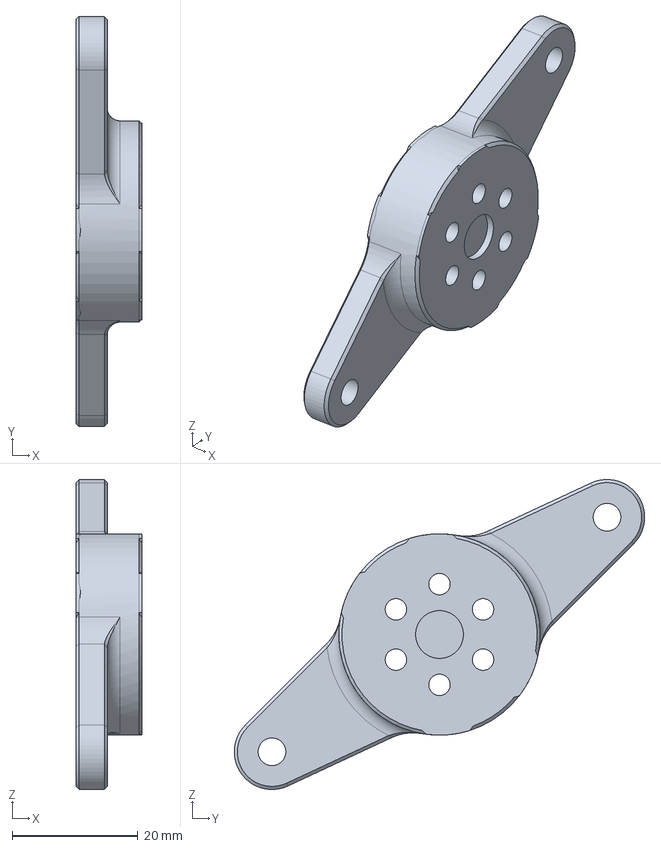
[picture p31: CAD file, 2026-10-12]
cad/parts/gripper_crank.step
10.5 x 65.2 x 49.3 mm
