ganiushin/MaGaRM/cad/parts/L5_shake.step

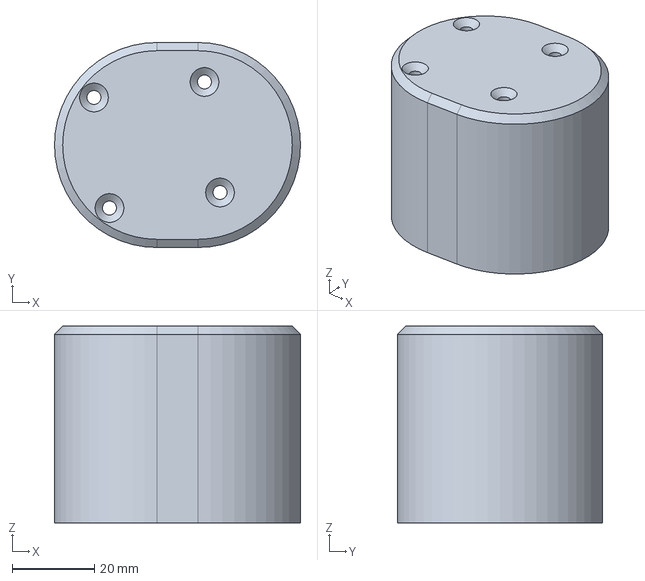
[picture p32: CAD file, 2026-10-12]
cad/parts/L5_shake.step
60.0 x 50.0 x 48.0 mm
