ganiushin/MaGaRM/cad/parts/L2_cheek.step

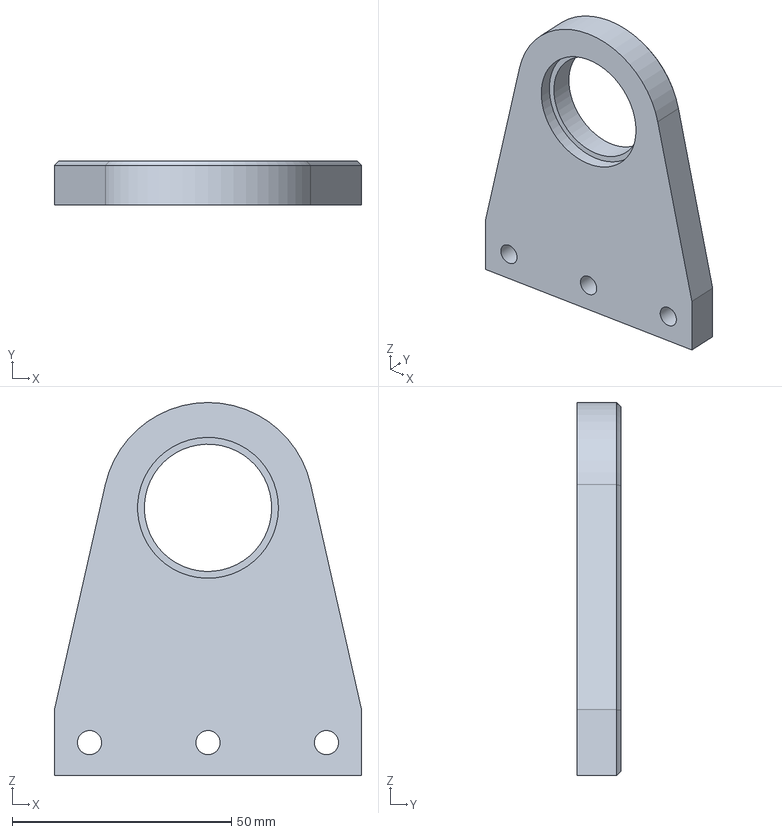
[picture p33: CAD file, 2026-10-12]
cad/parts/L2_cheek.step
70.0 x 10.0 x 85.0 mm
