ganiushin/MaGaRM/cad/parts/L7_motor.step

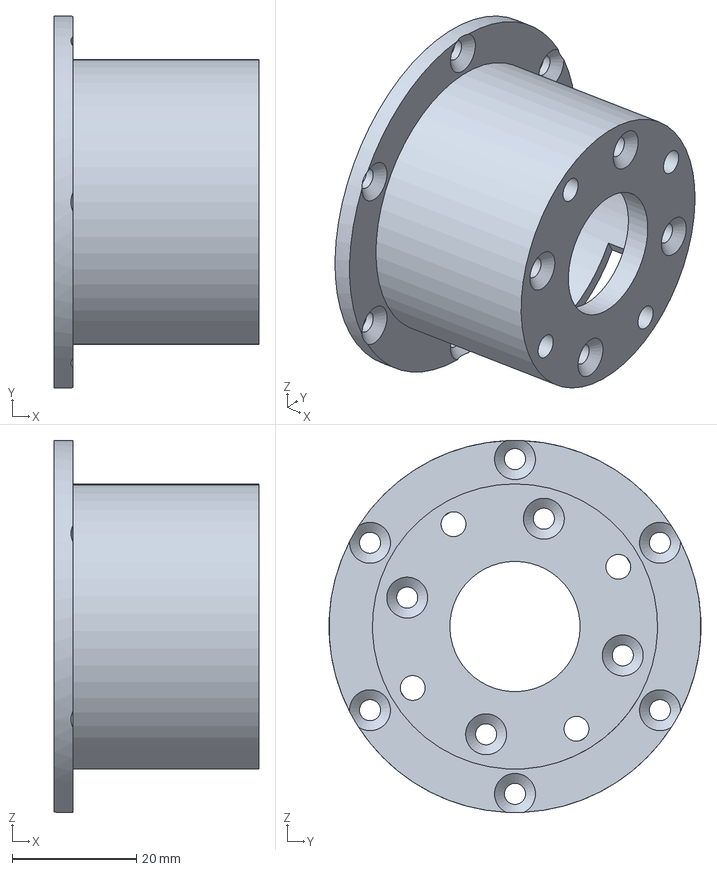
[picture p34: CAD file, 2026-10-12]
cad/parts/L7_motor.step
33.0 x 60.0 x 60.0 mm
