ganiushin/MaGaRM/cad/parts/camera_clamp.step

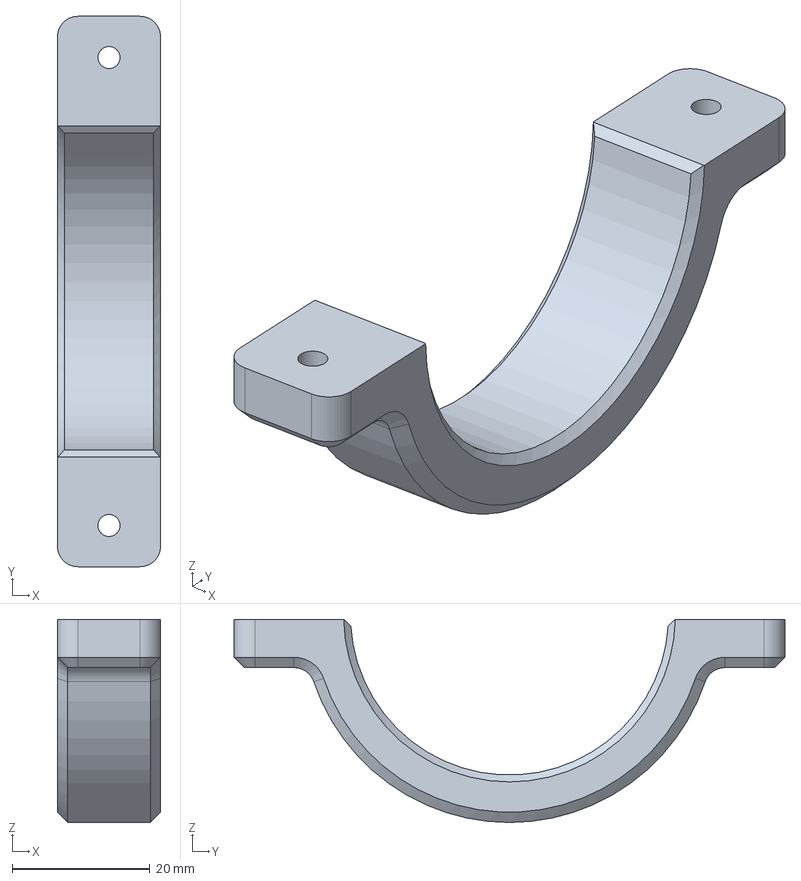
[picture p35: CAD file, 2026-10-12]
cad/parts/camera_clamp.step
15.0 x 80.0 x 29.5 mm
