ganiushin/MaGaRM/cad/parts/jaw_1_m.step

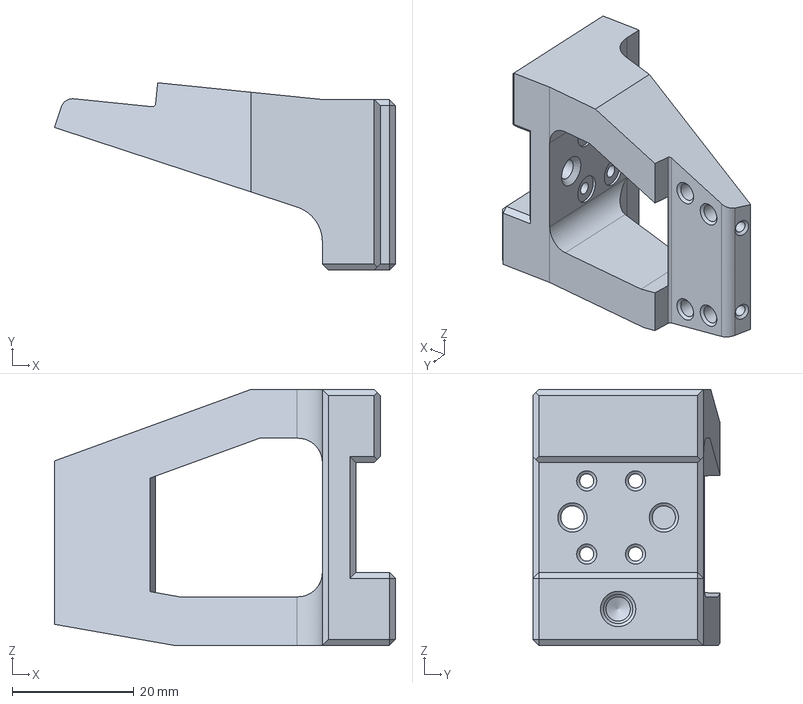
[picture p36: CAD file, 2026-10-12]
cad/parts/jaw_1_m.step
55.9 x 30.7 x 42.0 mm
