ganiushin/MaGaRM/cad/parts/L2_cover.step

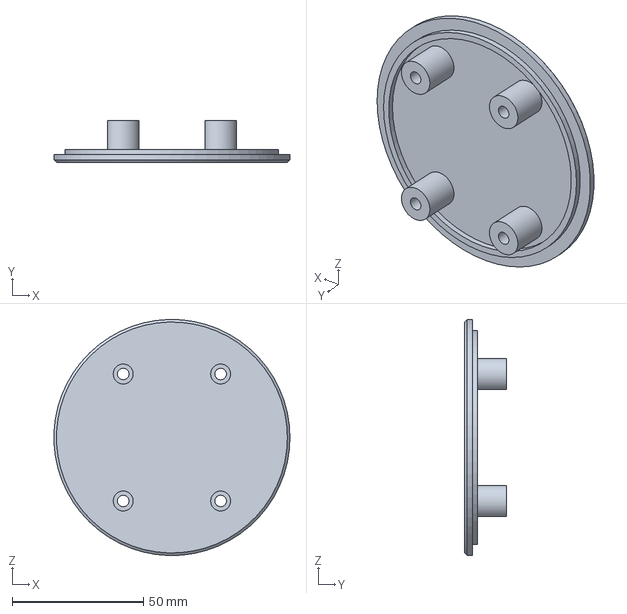
[picture p37: CAD file, 2026-10-12]
cad/parts/L2_cover.step
89.9 x 16.0 x 90.0 mm
