ganiushin/MaGaRM/cad/parts/handle_m.step

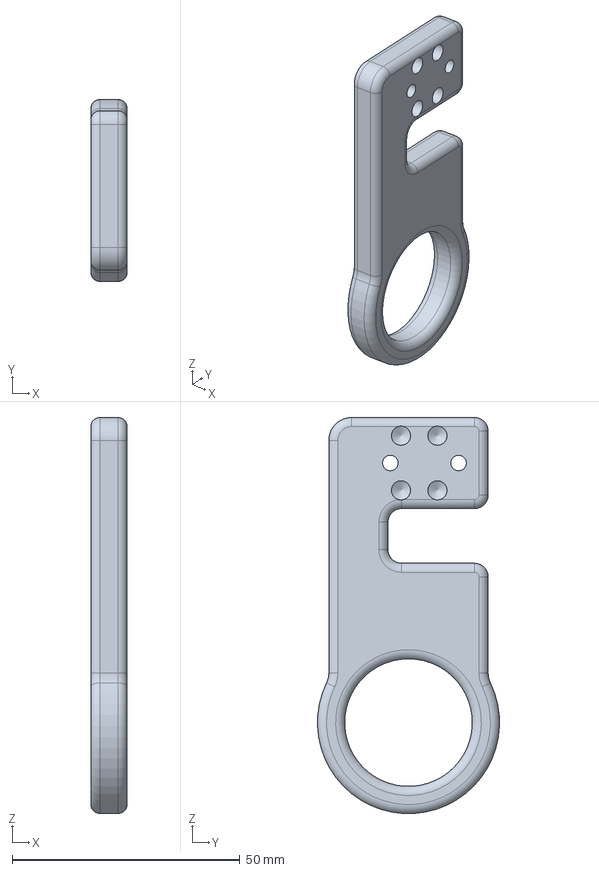
[picture p38: CAD file, 2026-10-07]
cad/parts/handle_m.step
8.00 x 40.0 x 87.0 mm
