ganiushin/MaGaRM/cad/parts/L5_side_plate.step

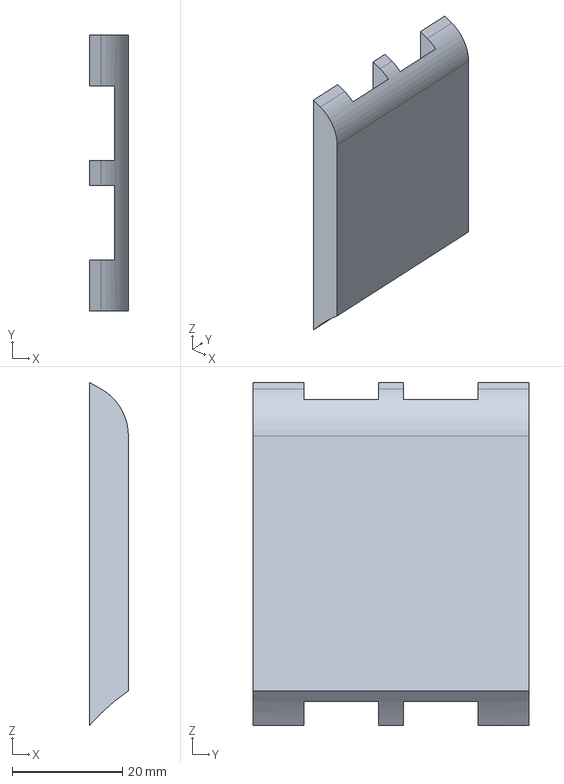
[picture p39: CAD file, 2026-10-07]
cad/parts/L5_side_plate.step
7.05 x 50.0 x 62.2 mm
