ganiushin/MaGaRM/(list of files, cad)

Other CAD files:
cad/parts/gripper_link_1.step
sim/assets/pad_l.stl
sim/assets/handle_r.stl
sim/assets/jaw_r.stl
sim/assets/rod_l.stl
cad/parts/jaw_1.step
cad/parts/jaw_pad.step
cad/parts/handle.step
cad/parts/L1_base.stl
cad/parts/L2_base.stl
cad/parts/L2_cheek.stl
cad/parts/L2_cover.stl
cad/parts/L3_back.stl
cad/parts/L3_motor.stl
cad/parts/L4_left.stl
cad/parts/L4_right.stl
cad/parts/L5_back.stl
cad/parts/L5_motor.stl
cad/parts/L5_shake.stl
cad/parts/L5_side_plate.stl
cad/parts/L6_link.stl
cad/parts/L7_base.stl
cad/parts/L7_cover.stl
cad/parts/L7_motor.stl
cad/parts/camera_bracket.stl
cad/parts/camera_clamp.stl
cad/parts/gripper_crank.stl
cad/parts/gripper_frame.stl
cad/parts/gripper_link_1.stl
cad/parts/gripper_link_2.stl
cad/parts/handle.stl
cad/parts/handle_m.stl
cad/parts/jaw_1.stl
cad/parts/jaw_1_m.stl
cad/parts/jaw_pad.stl
cad/parts/jaw_pad_m.stl
