ganiushin/MaGaRM/urdf/magarm.urdf

<?xml version="1.0"?>
<!-- MaGaRM, generated by cad/scripts/make_urdf.py from the CAD assembly. Zero pose = CAD pose (arm folded). -->
<robot name="magarm">
  <material name="blue"><color rgba="0.27 0.55 0.9 1"/></material>
  <material name="grey"><color rgba="0.3 0.31 0.34 1"/></material>
  <link name="base_link">
    <inertial>
      <origin xyz="-4.52737e-06 1.84001e-05 0.0486051" rpy="0 0 0"/>
      <mass value="1.0768"/>
      <inertia ixx="0.000849832" ixy="-1.11409e-07" ixz="-2.18357e-09" iyy="0.000843317" iyz="1.23198e-06" izz="0.000965692"/>
    </inertial>
    <visual><geometry><mesh filename="meshes/base_link.stl"/></geometry><material name="grey"/></visual>
    <collision><geometry><mesh filename="meshes/base_link.stl"/></geometry></collision>
  </link>
  <link name="link1">
    <inertial>
      <origin xyz="2.46476e-09 -0.00727928 0.025629" rpy="0 0 0"/>
      <mass value="0.1189"/>
      <inertia ixx="0.000210602" ixy="1.21163e-11" ixz="-5.68736e-12" iyy="0.000119699" iyz="2.09783e-05" izz="0.000184299"/>
    </inertial>
    <visual><geometry><mesh filename="meshes/link1.stl"/></geometry><material name="blue"/></visual>
    <collision><geometry><mesh filename="meshes/link1.stl"/></geometry></collision>
  </link>
  <link name="link2">
    <inertial>
      <origin xyz="0.0567126 -0.00426111 -9.87008e-06" rpy="0 0 0"/>
      <mass value="1.5728"/>
      <inertia ixx="0.00106506" ixy="-0.000154816" ixz="-1.70305e-06" iyy="0.0122876" iyz="1.0606e-06" izz="0.0121907"/>
    </inertial>
    <visual><geometry><mesh filename="meshes/link2.stl"/></geometry><material name="grey"/></visual>
    <collision><geometry><mesh filename="meshes/link2.stl"/></geometry></collision>
  </link>
  <link name="link3">
    <inertial>
      <origin xyz="-0.0707696 0.000269438 0.0546642" rpy="0 0 0"/>
      <mass value="0.2050"/>
      <inertia ixx="0.000278723" ixy="1.98366e-05" ixz="0.000124882" iyy="0.000966204" iyz="-5.75771e-06" izz="0.000973204"/>
    </inertial>
    <visual><geometry><mesh filename="meshes/link3.stl"/></geometry><material name="blue"/></visual>
    <collision><geometry><mesh filename="meshes/link3.stl"/></geometry></collision>
  </link>
  <link name="link4">
    <inertial>
      <origin xyz="-0.0217537 -0.00228743 0.0229284" rpy="0 0 0"/>
      <mass value="0.6543"/>
      <inertia ixx="0.000778009" ixy="3.28031e-05" ixz="0.000477614" iyy="0.00123868" iyz="-3.48528e-05" izz="0.000715628"/>
    </inertial>
    <visual><geometry><mesh filename="meshes/link4.stl"/></geometry><material name="grey"/></visual>
    <collision><geometry><mesh filename="meshes/link4.stl"/></geometry></collision>
  </link>
  <link name="link5">
    <inertial>
      <origin xyz="-0.00992942 4.69411e-05 -0.0368696" rpy="0 0 0"/>
      <mass value="0.2553"/>
      <inertia ixx="9.06579e-05" ixy="1.77997e-07" ixz="-2.33241e-06" iyy="0.000107884" iyz="-6.44231e-08" izz="0.000101017"/>
    </inertial>
    <visual><geometry><mesh filename="meshes/link5.stl"/></geometry><material name="blue"/></visual>
    <collision><geometry><mesh filename="meshes/link5.stl"/></geometry></collision>
  </link>
  <link name="link6">
    <inertial>
      <origin xyz="-0.0955147 -0.000207879 0.0193381" rpy="0 0 0"/>
      <mass value="0.3876"/>
      <inertia ixx="0.000819138" ixy="-2.27972e-07" ixz="4.43613e-05" iyy="0.000562021" iyz="-1.71756e-06" izz="0.000629617"/>
    </inertial>
    <visual><geometry><mesh filename="meshes/link6.stl"/></geometry><material name="blue"/></visual>
    <collision><geometry><mesh filename="meshes/link6.stl"/></geometry></collision>
  </link>
  <link name="gripper_link">
    <inertial>
      <origin xyz="-0.0059378 1.81956e-09 1.13126e-09" rpy="0 0 0"/>
      <mass value="0.0071"/>
      <inertia ixx="2.10657e-06" ixy="-9.72181e-15" ixz="-8.81271e-15" iyy="8.86642e-07" iyz="-6.25243e-07" izz="1.34179e-06"/>
    </inertial>
    <visual><geometry><mesh filename="meshes/gripper_link.stl"/></geometry><material name="blue"/></visual>
    <collision><geometry><mesh filename="meshes/gripper_link.stl"/></geometry></collision>
  </link>
  <link name="tcp"/>
  <joint name="joint1" type="revolute">
    <parent link="base_link"/><child link="link1"/>
    <origin xyz="0 0 0.08275" rpy="0 0 0"/>
    <axis xyz="0 0 1"/>
    <limit lower="-2.79253" upper="2.79253" effort="54.0" velocity="3.14"/>
  </joint>
  <joint name="joint2" type="revolute">
    <parent link="link1"/><child link="link2"/>
    <origin xyz="0 0 0.061" rpy="0 0 0"/>
    <axis xyz="0 -1 0"/>
    <limit lower="0.0" upper="3.49066" effort="54.0" velocity="3.14"/>
  </joint>
  <joint name="joint3" type="revolute">
    <parent link="link2"/><child link="link3"/>
    <origin xyz="0.19 0 0" rpy="0 0 0"/>
    <axis xyz="0 -1 0"/>
    <limit lower="-4.01426" upper="-0.0611" effort="27.0" velocity="5.8"/>
  </joint>
  <joint name="joint4" type="revolute">
    <parent link="link3"/><child link="link4"/>
    <origin xyz="-0.185 0 0.064" rpy="0 0 0"/>
    <axis xyz="0 -1 0"/>
    <limit lower="-0.8727" upper="1.5708" effort="27.0" velocity="5.8"/>
  </joint>
  <joint name="joint5" type="revolute">
    <parent link="link4"/><child link="link5"/>
    <origin xyz="-0.05455 0 0.038" rpy="0 0 0"/>
    <axis xyz="0 0 -1"/>
    <limit lower="-1.5708" upper="1.5708" effort="6.0" velocity="22.0"/>
  </joint>
  <joint name="joint6" type="revolute">
    <parent link="link5"/><child link="link6"/>
    <origin xyz="0.00681 0 -0.038" rpy="0 0 0"/>
    <axis xyz="1 0 0"/>
    <limit lower="-1.5708" upper="1.5708" effort="6.0" velocity="22.0"/>
  </joint>
  <joint name="gripper_joint" type="revolute">
    <parent link="link6"/><child link="gripper_link"/>
    <origin xyz="-0.09376 0 0" rpy="0 0 0"/>
    <axis xyz="1 0 0"/>
    <limit lower="-1.5708" upper="1.5708" effort="0.45" velocity="50.0"/>
  </joint>
  <joint name="tcp_joint" type="fixed">
    <parent link="link6"/><child link="tcp"/>
    <origin xyz="-0.17326 0 0" rpy="0 0 0"/>
  </joint>
</robot>
