ganiushin/MaGaRM/(commit log)

2026-10-07 MaGaRM: 6-DOF arm on Damiao and RobStride motors
    - cad/parts: 27 printed parts (STEP + watertight STL), parts.json, MaGaRM logo on the upper arm
    - cad/scripts: build from the base assembly (J1-J4, gripper, logo), parts export, URDF, viewer
    - cad/motors: official Damiao models; cad/fonts: Russo One (OFL)
    - urdf/magarm.urdf: kinematics, limits, meshes and mass properties from the CAD
    - software/magarm: Damiao MIT and RobStride EL05 drivers, Arm, tools, tests
    - docs: BOM, motor check and setup, electrics, software, CAD
    - viewer: three.js model of the whole arm
2026-10-07 Remove the J5-blocking side plate, J6-motor sweep relief in the wrist drum (J5 free ±90°)
2026-10-12 J1 and J2 on DM-JH17-101 harmonic motors: new base and shoulder housing, MuJoCo model
    J1: new base with a ring for the JH17, the 6707 bearing is gone.
    J2: the fork is replaced by a shoulder housing on the J1 output, the upper arm is bolted
    to the motor flange beside it (43 mm from the J1 axis). J2 range 0..200 deg.
    URDF, joint config and docs follow. sim/: MuJoCo model with the closed-chain gripper,
    scene and pick-and-place demo. Logs are ignored.
2026-10-12 Viewer: declare UTF-8, let the canvas take the mouse after loading, J1/J2 text for the JH17 motors
2026-10-12 J2 as a fork with the JH17 inside the upper arm, bearing cheek on the other side; teleop handles removed
    The J2 end of the upper arm becomes a drum for the motor, the fork holds the output flange and a 6705 on a
    bolted-on cheek. J1 sits under the arm mid-plane, 61 mm below the J2 axis. J3 fold stop at 3.5 deg.
    Sim: plate collision as a box, coarser motor meshes for the URDF.
